KeioRoboticsAssociation/MD_Stable/MD_Stable.xlsx

番号 | 数量 | リファレンス | 定数 | 部品種別 | 形状 | 単価 | 必要分/最小購入数 | 小計 | 調達場所 | 秋月通販コード | 備考
1 | 47 | C1,C2,C3,C5,C7,C8,C9,C12,C13,C14,C15,C16,C19,C20,C21,C22,C23,C24,C25,C26,C27,C28,C29,C30,C46,C47,C48,C49,C50,C51,C52,C53,C54,C56,C57,C58,C59,C60,C61,C62,C78,C79,C80,C81,C82,C83,C84 | 0.1u | 積セラ | 1608 |  | 47 | 0 | 部室
2 | 3 | C4,C6,C17 | 16V 100u | アルミ電解 |  |  | 3 | 0 | 部室
3 | 2 | C10,C11 | 50v 100u | アルミ電解 |  |  | 2 | 0 | 部室
4 | 1 | C18 | 16v 100u | アルミ電解 |  |  | 1 | 0 | 部室
5 | 24 | C31,C32,C33,C34,C35,C36,C40,C41,C42,C43,C44,C45,C63,C64,C66,C67,C69,C70,C72,C73,C74,C75,C76,C77 | 1u | 積セラ | 1608 | 10 | 24 | 240 | 秋月 | 116994
6 | 6 | C37,C38,C39,C65,C68,C71 | 0.22u | 積セラ | 1608 | 10 | 6 | 60 | 秋月 | 114556
7 | 1 | C55 | 0.01u | 積セラ | 1608 |  | 1 | 0 | 部室
8 | 62 | D1,D2,D3,D4,D6,D7,D8,D9,D10,D12,D13,D16,D19,D21,D22,D23,D24,D25,D26,D27,D28,D29,D30,D31,D32,D33,D34,D35,D36,D37,D38,D39,D40,D41,D42,D49,D50,D51,D52,D53,D54,D55,D56,D57,D58,D59,D60,D61,D62,D63,D64,D65,D66,D67,D68,D69,D70,D71,D72,D73,D74,D75 | 1N4148W | ショットキーバリアダイオード | SOD-123 | 4 | 62 | 248 | 秋月 | 116985
9 | 7 | D5,D11,D14,D15,D17,D18,D20 | LED | チップLED | 1608 |  | 7 | 0 | 秋月
10 | 3 | D43,D45,D47 | LED_A | チップLED | 1608 |  | 3 | 0 | 秋月
11 | 3 | D44,D46,D48 | LED_B | チップLED | 1608 |  | 3 | 0 | 部室
12 | 1 | F1 | Polyfuse | ポリヒューズ |  |  | 1 | 0 | 部室
13 | 1 | J1 | Conn_02x04_Counter_Clockwise | DIPスイッチ |  | 70 | 1 | 70 | 秋月 | 116584
14 | 1 | J2 | XT30_Male | XT30オス |  | 70 | 1 | 70 | 秋月 | 117949
15 | 1 | J3 | XT60_Male | XT60オス |  |  | 1 | 0 | 部室
16 | 1 | J4 | RE1 | ポケットヘッダ5ピン |  |  | 1 | 0 | 部室
17 | 1 | J5 | RE2 | ポケットヘッダ5ピン5ピン |  |  | 1 | 0 | 部室
18 | 1 | J6 | RE3 | ポケットヘッダ5ピン |  |  | 1 | 0 | 部室
19 | 1 | J7 | MO_XT60_Female1 | XT60メス |  |  | 1 | 0 | 部室
20 | 1 | J8 | MO_XT60_Female2 | XT60メス |  |  | 1 | 0 | 部室
21 | 1 | J9 | MO_XT60_Female3 | XT60メス |  |  | 1 | 0 | 部室
22 | 1 | J10 | Conn_02x06_Odd_Even | ピンソケット2x6ピン |  |  | 1 | 0 | 部室
23 | 1 | J11 | Conn_01x08_Pin | ピンヘッダ8ピン |  |  | 1 | 0 | 部室
24 | 1 | J12 | Conn_01x05_Socket | XH5ピン |  | 15 | 1 | 15 | 秋月 | 112428
25 | 12 | Q1,Q2,Q3,Q4,Q5,Q6,Q7,Q8,Q9,Q10,Q11,Q12 | TPH4R008QM | NchMOSFET | 8-SOP Advance (5x5.75) | 192 | 12 | 2304 | Digikey
26 | 27 | R1,R2,R3,R4,R5,R6,R7,R8,R9,R12,R15,R16,R18,R19,R20,R22,R23,R24,R25,R26,R27,R28,R29,R42,R75,R76,R77 | 10k | 抵抗 | 1608 |  | 27 | 0 | 部室
27 | 4 | R10,R14,R17,R21 | 1k | 抵抗 | 1608 |  | 4 | 0 | 部室
28 | 5 | R11,R13,R49,R50,R51 | 24k | 抵抗 | 1608 |  | 5 | 0 | 部室
29 | 24 | R30,R31,R32,R33,R34,R35,R43,R44,R45,R46,R47,R48,R57,R58,R59,R60,R61,R62,R69,R70,R71,R72,R73,R74 | 47 | 抵抗 | 1608 |  | 24 | 0 | 部室
30 | 12 | R36,R37,R38,R39,R40,R41,R63,R64,R65,R66,R67,R68 | 47k | 抵抗 | 1608 |  | 12 | 0 | 部室
31 | 5 | R52,R53,R54,R78,R79 | 120 | 抵抗 | 1608 |  | 5 | 0 | 部室
32 | 2 | R55,R56 | 240 | 抵抗 | 1608 |  | 2 | 0 | 部室
33 | 4 | R80,R81,R82,R83 | 2.2k | 抵抗 | 1608 |  | 4 | 0 | 部室
34 | 2 | SW1,SW2 | SW_Push | タクトスイッチ |  |  | 2 | 0 | 秋月
35 | 3 | SW3,SW4,SW5 | PWM | タクトスイッチ |  |  | 3 | 0 | 108216と108214
36 | 3 | SW6,SW7,SW8 | DIR | タクトスイッチ |  |  | 3 | 0 | 108073
37 | 1 | U1 | NJM7808SDL1 | 3端子 | TO-252-2 |  | 1 | 0 | 110977
38 | 2 | U2,U4 | BA05CC0T縺ｫ莨ｼ縺滉ｽ輔° | 3端子 | TO-252-2 |  | 2 | 0 | 部室
39 | 1 | U3 | STM32G431K8Tx | マイコン | LQFP-32 |  | 1 | 0 | 部室
40 | 1 | U5 | BA033CC0FP | 3端子 | TO-252-2 |  | 1 | 0 | 部室
41 | 1 | U6 | ﾏ 160M60 | デジタルアイソレータ | SOIC-16 |  | 1 | 0 | 部室
42 | 3 | U7,U8,U9 | 74AHC1G04W5 | インバータ | SOT-23-5 |  | 3 | 0 | 部室 | 117602
43 | 6 | U10,U11,U12,U20,U21,U22 | 74AHC1G08W5 | AND回路 | SOT-23-5 |  | 6 | 0 | 秋月 | 117603
44 | 6 | U13,U14,U15,U17,U18,U19 | IRS2302S | ゲートドライバ | SOIC-8 | 260 | 6 | 1560 | 秋月 | 115656
45 | 1 | U16 | NE555D | タイマーIC | SOIC-8 | 30 | 1 | 30 | 秋月 | 116210
46 | 2 | U23,U24 | UTRS485G-S08-R | RS-485ドライバ | SOP-8 |  | 2 | 0 | 部室 | 116376
 |  |  |  |  |  |  |  | 4597
