KeioRoboticsAssociation/MD_Stable/schema.pdf

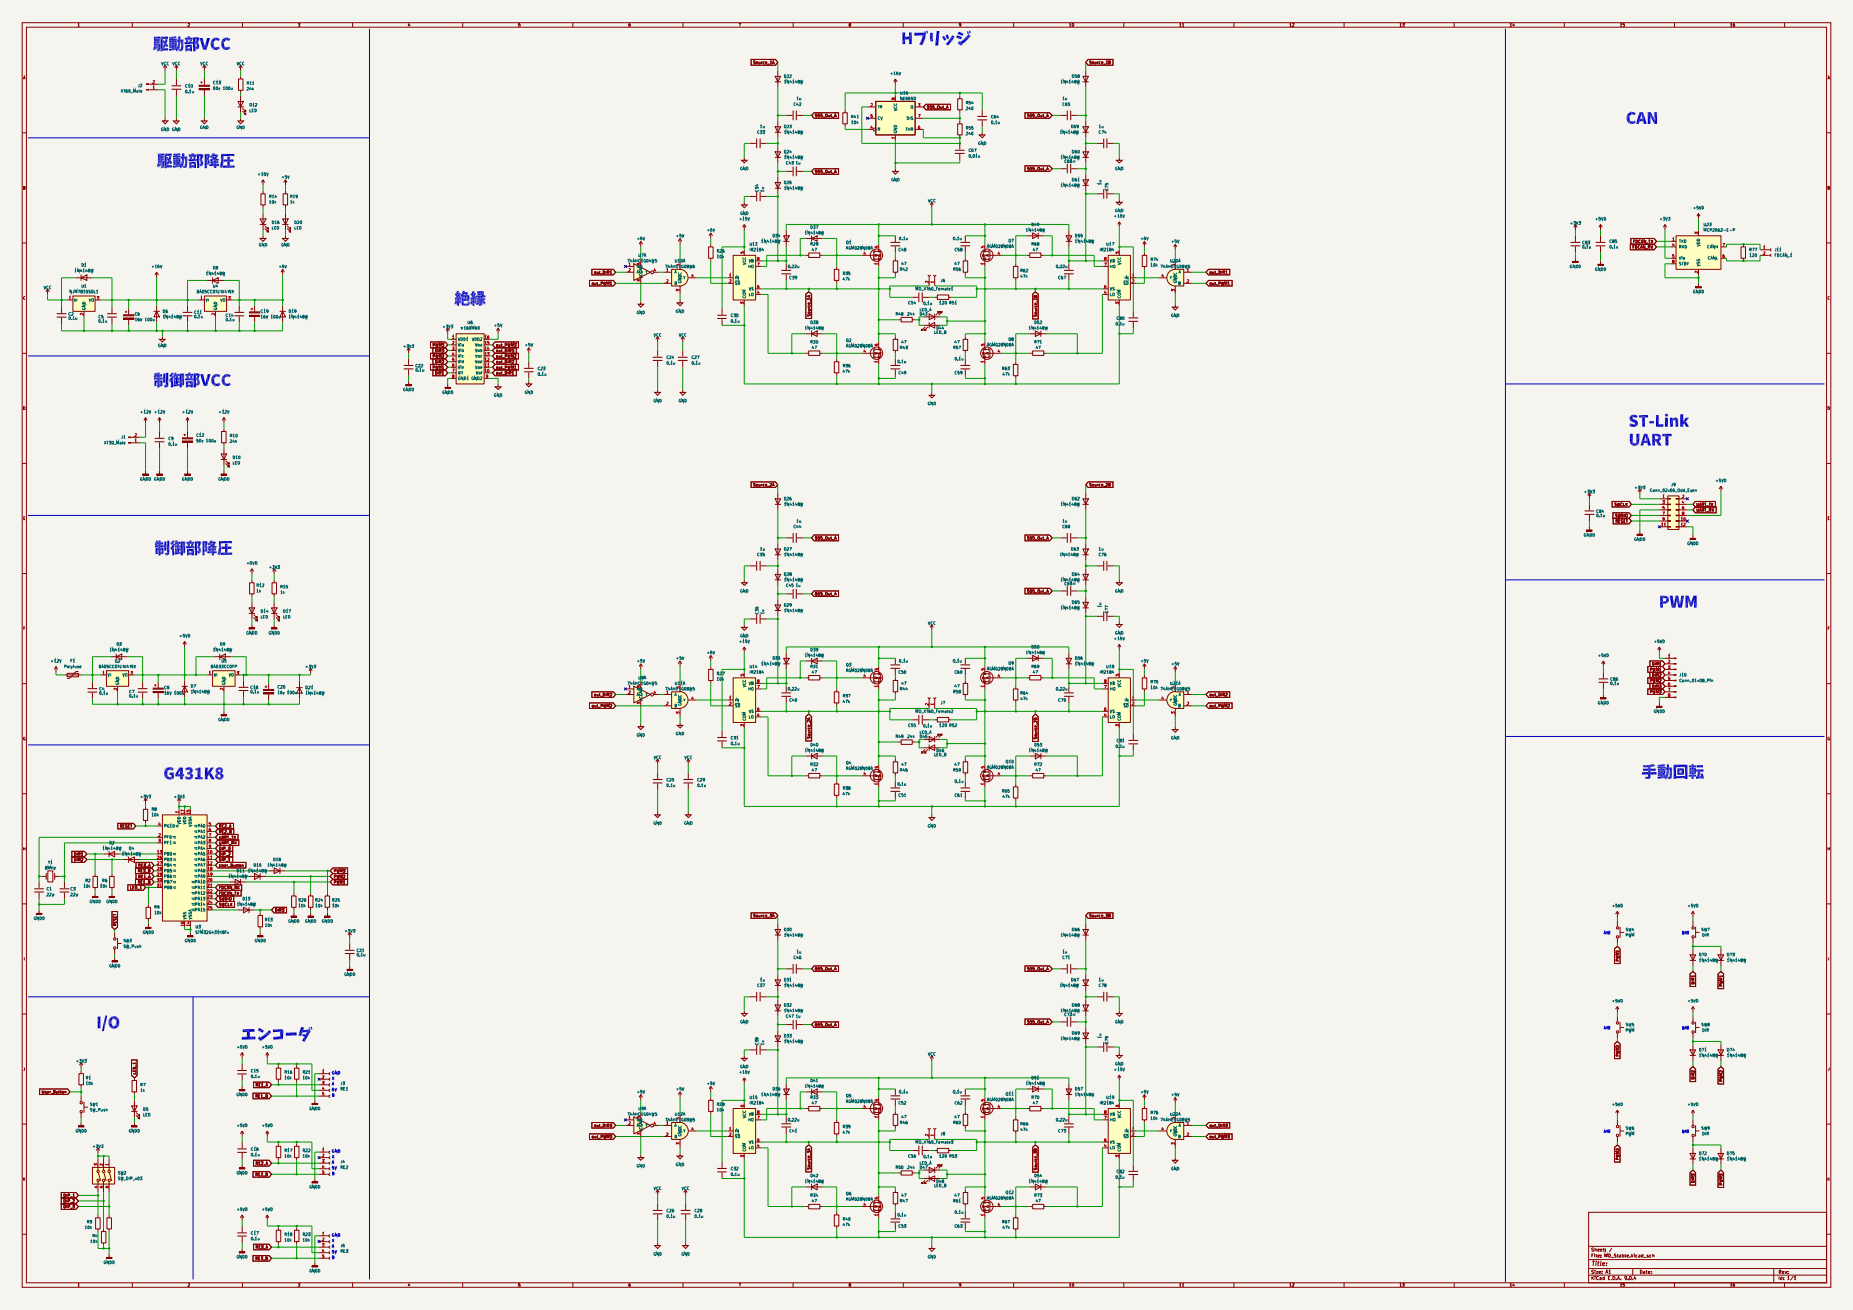
[picture p1: page 1]
