KeioRoboticsAssociation/MD_Stable/MD_Stable.kicad_pcb

## KiCad design MD_Stable.kicad_pcb (continued)

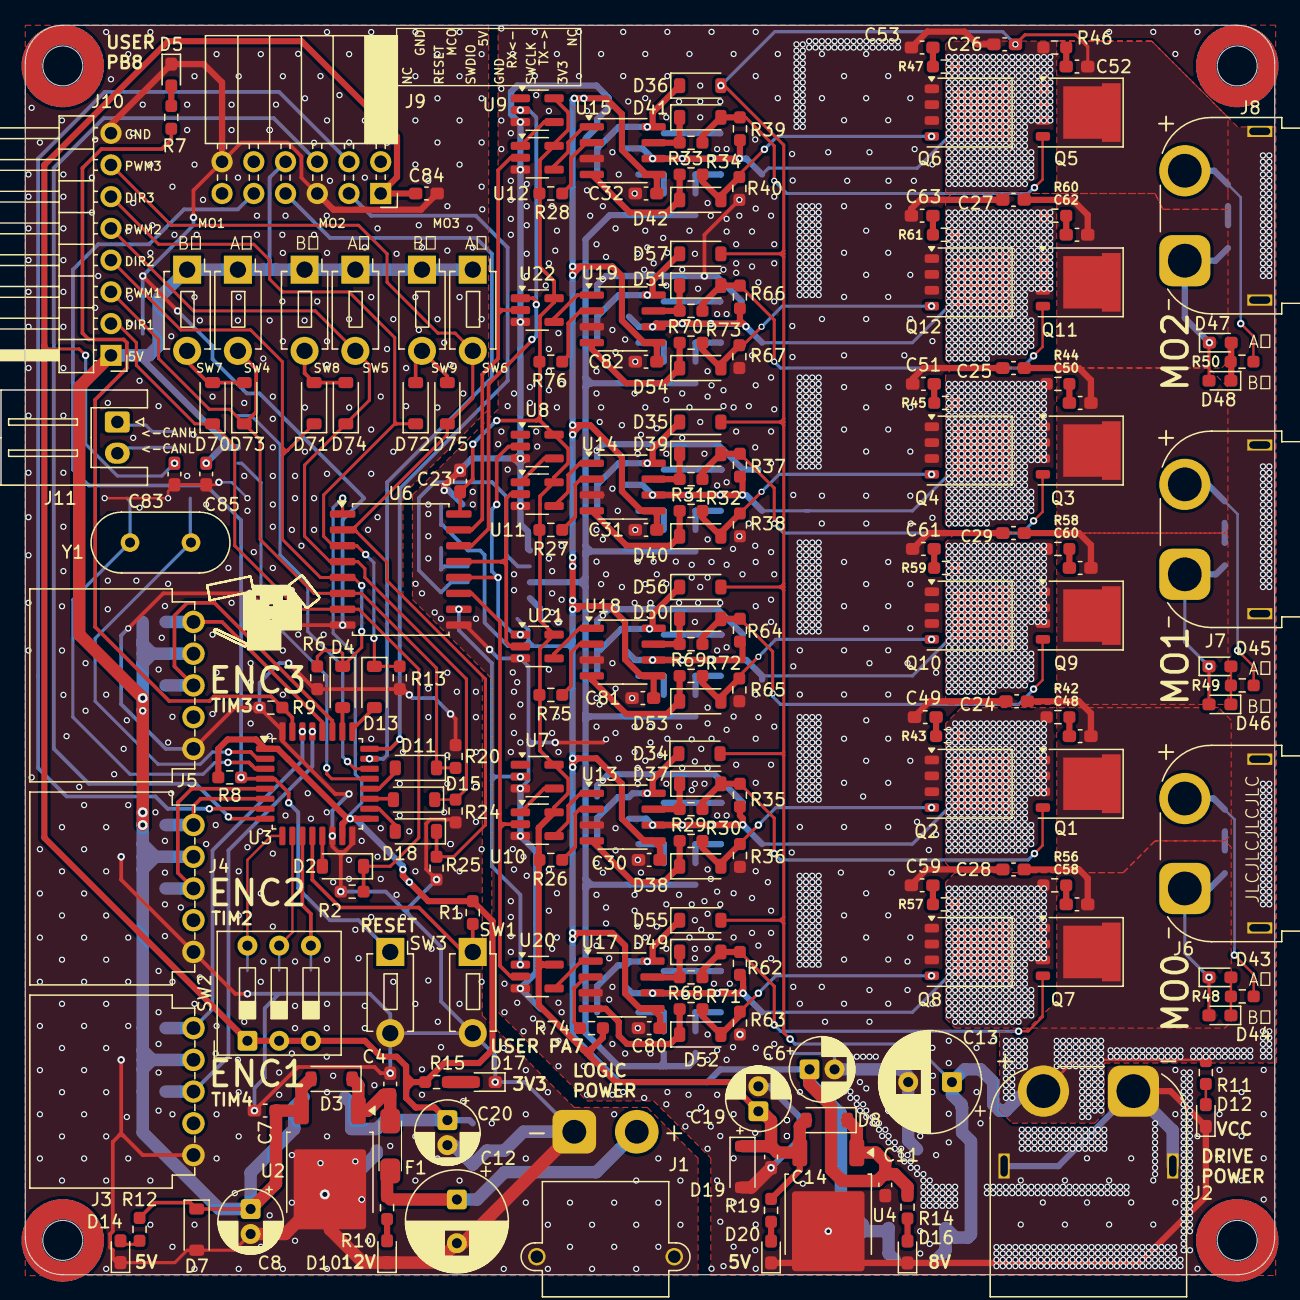
[picture p8: board MD_Stable.kicad_pcb from above]

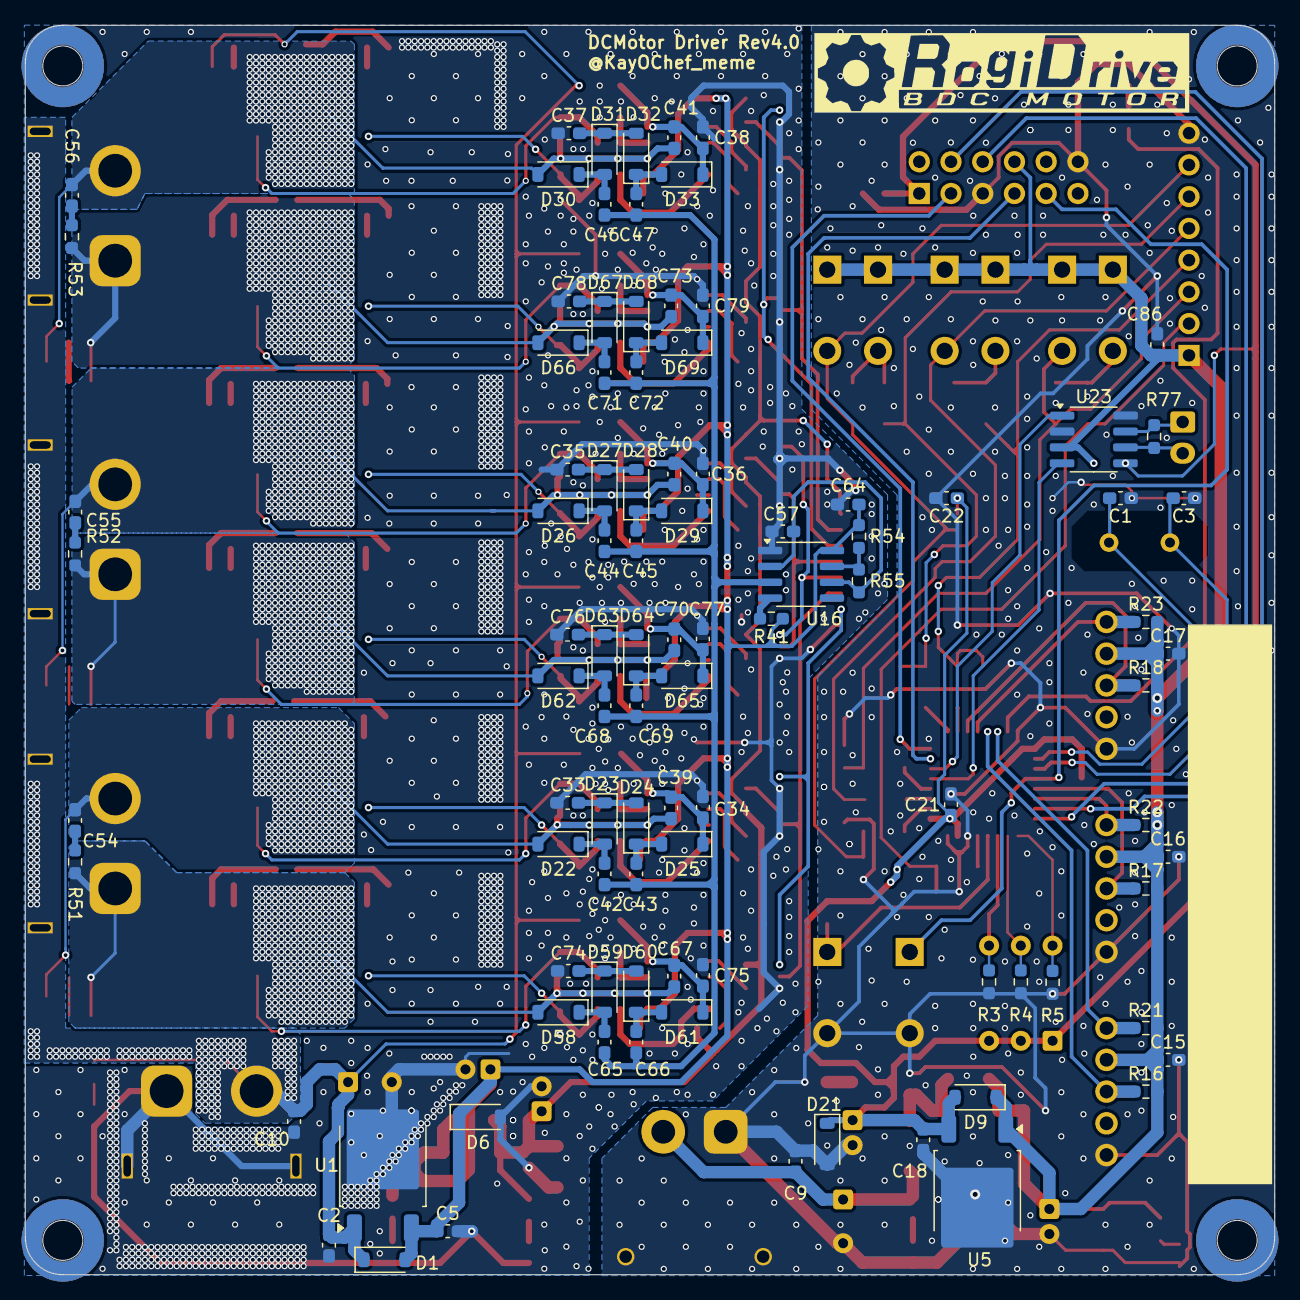
[picture p9: board MD_Stable.kicad_pcb from below]

Board: 2 copper layers, 100.0 x 100.0 mm, 296 parts (96 on the bottom side), 150 nets.

Other parts of the board:
ref**: val**; ROGIKEN
