KeioRoboticsAssociation/MD_Stable/(commit log)

2025-09-25 がちでgit使えるやん
    [MD_Stable.kicad_pcb, MD_Stable.kicad_sch]
2025-09-25 電装班がGitHubに上陸
    [MD_Stable.kicad_sch]
2025-10-01 回路図おおむね完成
    [MD_Stable.kicad_sch]
2025-10-02 配線し始めた
    [MD_Stable.kicad_pcb, MD_Stable.kicad_sch]
2025-10-03 配線終わり見えてきた
    [MD_Stable.kicad_pcb, MD_Stable.kicad_sch]
2025-10-05 MD基板完成
    [MD_Stable.kicad_pcb, MD_Stable.kicad_sch]
2025-10-14 製造番号位置指定
    [MD_Stable.kicad_pcb]
2025-11-28 配線修正
2026-01-08 RS485Tx fix
    [MD_Stable-B_Cu.gbr, MD_Stable-B_Mask.gbr, MD_Stable-B_Paste.gbr, MD_Stable-B_Silkscreen.gbr, MD_Stable-Edge_Cuts.gbr, MD_Stable-F_Cu.gbr, MD_Stable-F_Mask.gbr, MD_Stable-F_Paste.gbr]
2026-04-28 beyond the MD10C Rev4.0
    [MD_Stable-B_Cu.gbr, MD_Stable-B_Mask.gbr, MD_Stable-B_Paste.gbr, MD_Stable-B_Silkscreen.gbr, MD_Stable-Edge_Cuts.gbr, MD_Stable-F_Cu.gbr, MD_Stable-F_Mask.gbr, MD_Stable-F_Paste.gbr]
2026-05-03 時代はね、CANなんすよ
    [MD_Stable-B_Cu.gbr, MD_Stable-B_Mask.gbr, MD_Stable-B_Paste.gbr, MD_Stable-B_Silkscreen.gbr, MD_Stable-Edge_Cuts.gbr, MD_Stable-F_Cu.gbr, MD_Stable-F_Mask.gbr, MD_Stable-F_Paste.gbr]
